Ritwik-Rai/Convex-Hull-Computation-Circuit/(list of files, drawings)

Other design files:
Digisim_PS_final.pdsprj
